KriishAHate/CommonSENSES/README.md

# Urban Sensor Box

Built at the [Environmental Sensing Laboratory](https://envsensorslab.sites.northeastern.edu/) at Northeastern University as part of the [Common Senses Project](https://www.commonsensesproject.org/).

Full build guide: **[https://envsensorslab.github.io/CommonSENSES/](https://envsensorslab.github.io/CommonSENSES/)**

---

## Repository Structure

```
├── assets/        ← engineering drawings, QA cards, code files
├── bom.md         ← bill of materials
├── code/          ← code setup guide
├── deployment/    ← deployment guide
├── electronics/   ← electronics assembly guide
├── mechanical/    ← mechanical assembly guide
└── index.md       ← home page
```
