KriishAHate/CommonSENSES/docs/assets/Deploymentprocedurelist.pdf

Deployment- PROCEDURE LIST

Operator Name: __________________________ Date: _______________

Sensor Box Mounting Tasks

Device Placement

Transport the pre-assembled device to the installation site.

Place the box on its clamp side (the side with the box closing latches).
Caution: Do not place the box on the side with the solar shield to avoid potential damage to external components.

Mounting Procedure

Position the box on the pole at a height of 10 feet to the bottom of the box and ensure that it faces true south (approximately 14 degrees offset from magnetic south at 194 degrees) using the compass.

Secure the box using two hose clamps by passing them through the cross members as shown in the picture:

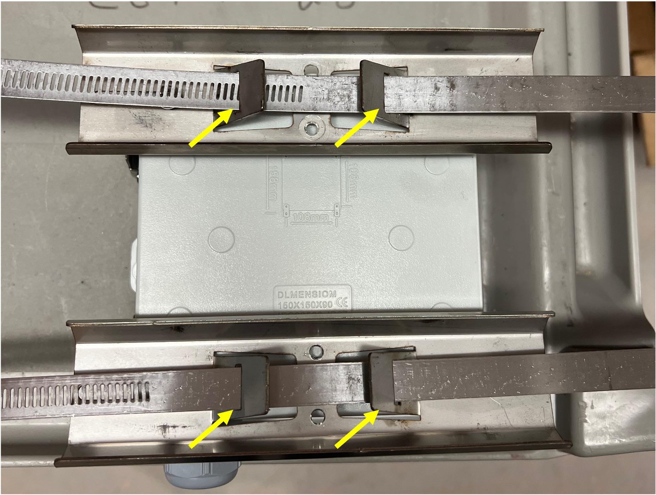
[picture p8: figure]

Lightly tighten the first hose clamp to hold the box in place.

Partially tighten the second clamp so the box is close to secure but can still be rotated to correct southern facing position.

Once both clamps and the solar panel are positioned correctly, fully tighten both to secure the box firmly.

Clip the excess hose clamps using a cutter.

Sensor Box Startup Verification

Power Up

Connect the USB cable to the power bank, use the port as shown in the picture.

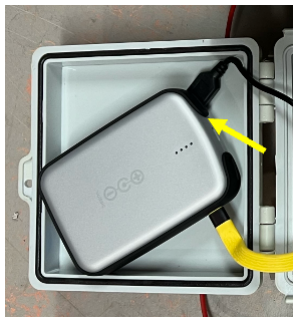
[picture p9: figure]

Press the button on the power bank to verify it has full charge. 4/4 points will light up and the red indicator for the arduino will turn on as shown in the picture.
Note: in some cases due to the winter the points take some time to show up or don't show up at all. In this case proceed with the visual indicator check to confirm that the Arduino is getting power and then look for the sound sensor and LTE module lights.

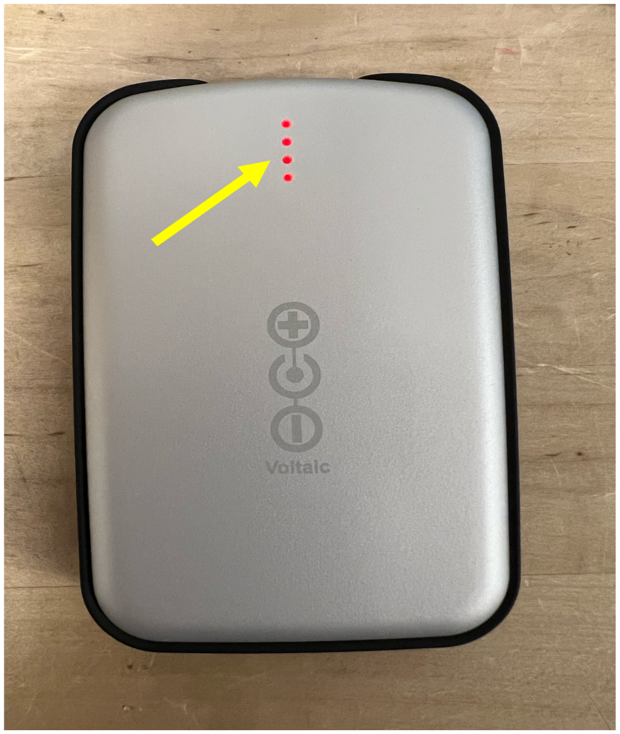
[picture p10: figure]

Visual Indicator Check

- Confirm that all indicator lights are functioning:

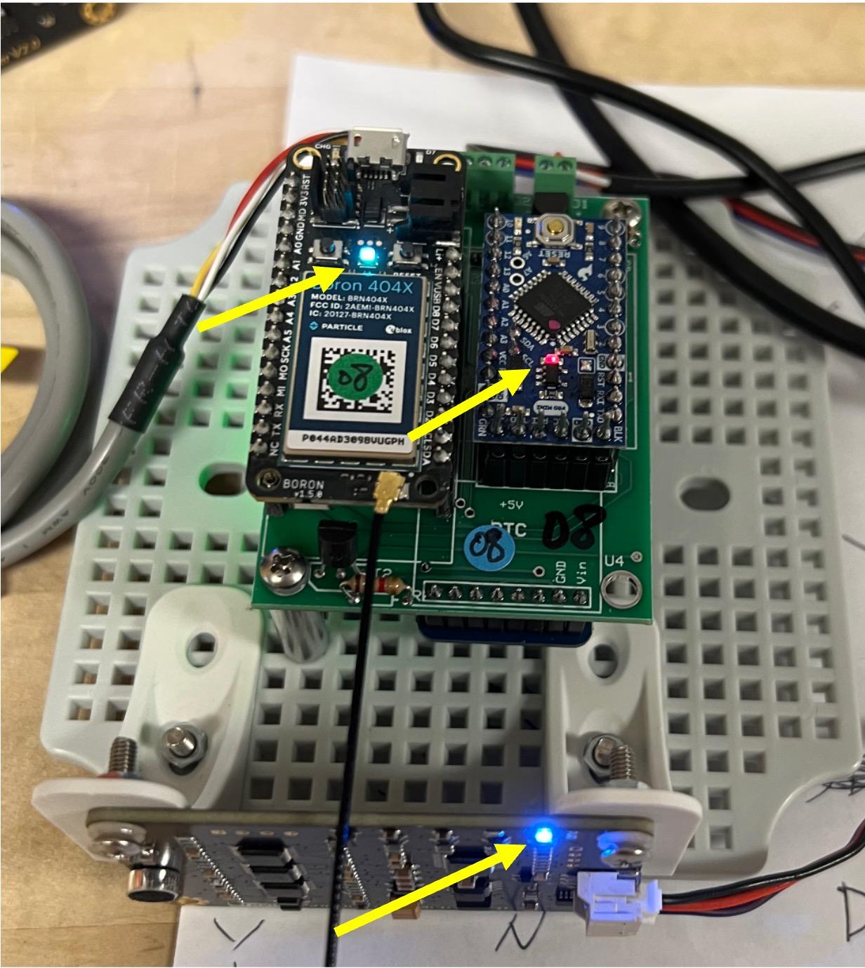
[picture p11: figure]

- Indicator Light Confirmation:

Arduino Green Light: ☐ Yes ☐ No

Sound Sensor Blue Light: ☐ Yes ☐ No

LTE Module Light Blue Light: ☐ Yes ☐ No

Data Upload Confirmation (Particle.io): ☐ Successful ☐ Not Successful (Retrieve box and use the spare boxes that are brought)

Data Transmission Verification

- Log into the particle io website to look for the startup message the module sends when it is powered up to confirm that the cellular module is uploading data. Verify that the Box number matches the Box number in the message as shown by the picture.

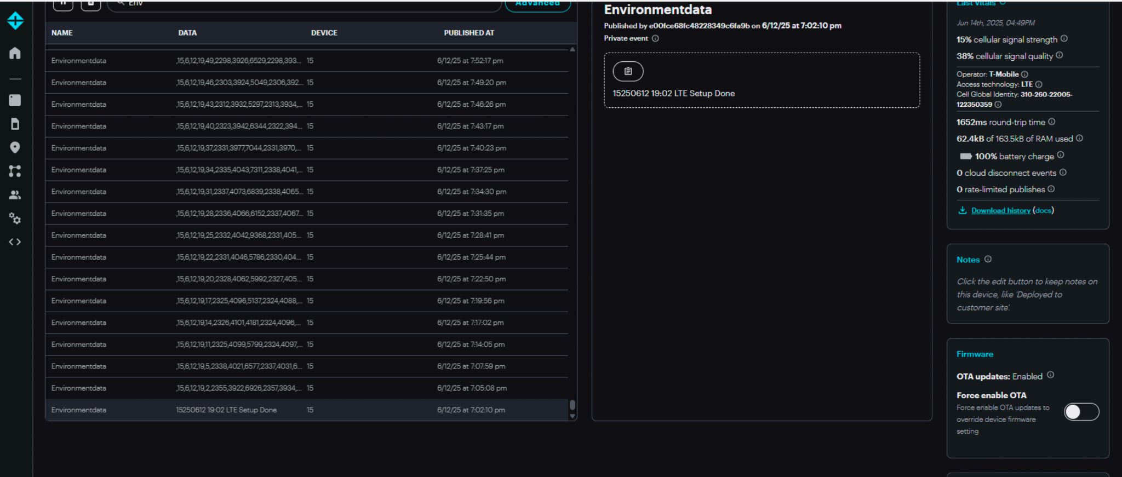
[picture p12: figure]

Box Closing

Check that no electronic wires are caught or pinched before attempting to close the door. Note: Improper closure can seriously affect internal components and cause failures. Close the box door and secure it by threading a zip tie through the hole located on the outer edge of the box as shown in the picture.

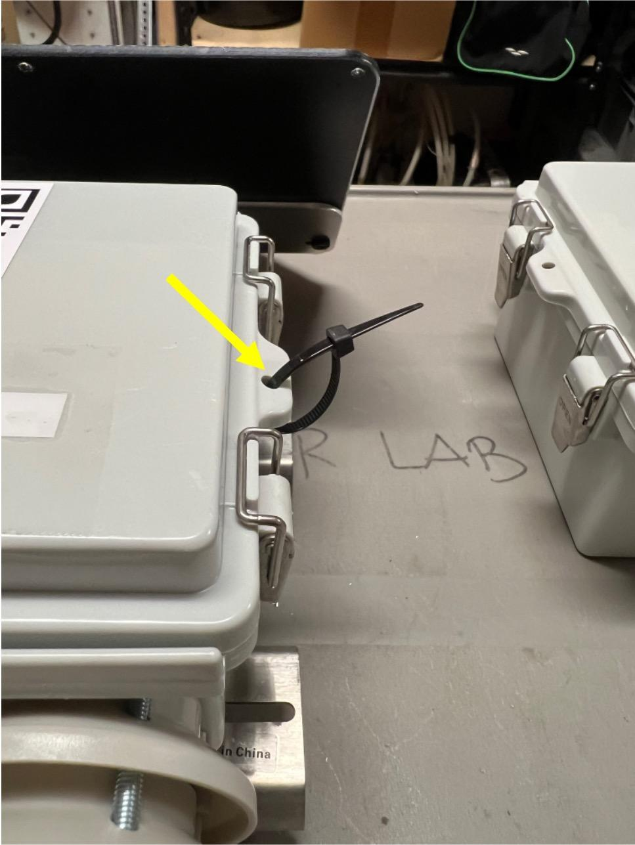
[picture p13: figure]

Important: While closing, ensure the power cable and the yellow solar panel charging cable is not interfering with the box door.

Installation Checklist Recording

- GPS Location: ____________
- Box Number: ____________
- Time of turning on the box after Installation: ________________
- Battery Voltage # of Points: ________________
- Photograph taken☐ Yes ☐ No
