KriishAHate/CommonSENSES/docs/assets/fielddaypackinglist.pdf

Operator Name: ___________ Date: ___________

Essential Tools:

Cordless power drill and extra batteries (charged)

Measuring tape

Socket driver 5/16”

Flathead screwdriver ¼”

Phillips head screwdriver

Precision screwdriver (for small screw terminals)

Large diagonal cutters and large needle nose pliers (for trimming excess hose clamp material)

Utility cutter or small diagonal cutters (for cutting zip ties)

Cart

PPE (Helemts, Reflective Vests)

Work Gloves

Ladder

Installation Components:

Signs (number to be installed) -Qty 8

Mounting hardware for signs (Nuts, Clamps, Wrench, Loctite–In BANDIT BOX)

Hose clamps – 2 per box plus 2 per sign

UV-resistant tape

UV-resistant zip ties (assorted sizes)

Masking tape (to mark 10 ft height)

Deployment Units:

Primary deployment sensor boxes (number to be installed) - Qty 6

Spare/extra deployment boxes – Qty 2

Marking & Orientation and Checklists:

Permanent marker + extra sharpies (Sharpie)

Magnetic compass (for ensuring correct southern orientation of boxes)

Clipboard (Also get binder clips to avoid pages from flying in the field) with 1 set of

packing list and # installation checklists based on number to be installed on the

respective day
