KriishAHate/CommonSENSES/docs/assets/PCBqacard.pdf

PCB Assembly | QA Card

## PCB Assembly QA Card

Inspection Checklist for Soldered PCB

Board Number: | Technician:

Checklist:

□ Solder 2 resistors

Ensure resistors are correctly placed and soldered with clean joints

□ Solder RTC, SD, and ADC female headers

Headers aligned straight and flush with the PCB; no cold joints

□ Solder LTE and Arduino female headers

Verify SDA and SCL header pins are included and correctly oriented

□ Solder 2 MOSFETs

MOSFET orientation must match PCB silkscreen marking

□ Solder 3 screw terminals

Confirm orientation (receiver should face away from the PCB) and that terminals are seated flat on PCB

□ Even solder amount and shape

Concave, shiny finish; no cold joints or solder bridges

□ Visual inspection complete

Check for missing pins, bridges, or cold joints

□ Continuity test passed

Use multimeter to confirm electrical continuity for all signal and power pins

Final Status: □ | Passed | □ | Needs Rework

Date:

Notes:

1
