KriishAHate/CommonSENSES/docs/assets/SDcardqacard.pdf

SD Card Module | QA Card

## SD Card Module QA Card

Individual SD Module Inspection

Board Number: | Technician:

Checklist:

□ Header orientation correct

Placed in correct direction where the SD card is oriented towards the RTC Module. It should sit on the smaller header pins.

□ Soldered SD header securely

Header sits flush; joint fully connects pin and pad

□ Even solder amount and shape

Concave, shiny finish; no cold joints or solder bridges

□ Visual inspection complete

Check for solder bridges or incomplete joints

□ Continuity test passed

Place one multimeter probe on a pin and the other on the adjacent pin to ensure no shorts. Repeat across all pairs of adjacent pins.

Final Status: □ | Passed | □ | Needs Rework

Date:

Notes:

1
