KriishAHate/CommonSENSES/docs/bom.md

# Bill of Materials

Everything you need to build one sensor box. Buy all of these items before you start assembly.

**Estimated total cost per unit: ~$450–$500**

---

## Electronics

| Part | Qty | Cost | Link |
|---|-----|---|---|
| Particle Boron 404X (cellular module) | 1 | $48.95 | [store.particle.io](https://store.particle.io/products/boron-lte-cat-m1-noram-with-ethersim-4th-gen) |
| Arduino Pro Mini 328P (5V) | 1 | $11.95 | [SparkFun](https://www.sparkfun.com/products/11113) |
| AM2315C Temperature + Humidity Sensor | 1 | $26.95 | [Adafruit](https://www.adafruit.com/product/5182) |
| SEN0232 Sound Level Sensor | 1 | $39.50 | [DigiKey](https://www.digikey.com/en/products/detail/dfrobot/SEN0232/8122314) |
| Sound sensor bracket | 30 | $8.79 | [Amazon](https://www.amazon.com/dp/B0CK17CSX7) |
| DS3231 Real-Time Clock | 1 | $17.50 | [Adafruit](https://www.adafruit.com/product/3013) |
| ADS1115 ADC | 1 | $14.95 | [Adafruit](https://www.adafruit.com/product/1085) |
| Adafruit MicroSD Card Breakout Board | 1 | $7.50 | [Adafruit](https://www.adafruit.com/product/254) |
| SD Card | 1 | $8.66 | [Amazon](https://www.amazon.com/dp/B010NE3QHQ) |
| CR1220 Coin Cell Battery (for RTC) | 1 | $0.95 | [Adafruit](https://www.adafruit.com/product/380) |
| Custom PCB | 1 | $13.30 | See repo |
| PCB female headers | 39 | $10.18 | [DigiKey](https://www.digikey.com/en/products/detail/preci-dip/801-87-003-10-001101/3757430) |
| PCB male headers | 39 | $6.91 | [DigiKey](https://www.digikey.com/en/products/detail/harwin-inc/D01-9923246/3918909) |
| TN0702 N-channel MOSFET | 1 | $1.52 | [DigiKey](https://www.digikey.com/en/products/detail/microchip-technology/TN0702N3-G/4902376) |
| 1kΩ Resistor | 1 | $0.10 | [DigiKey](https://www.digikey.com/en/products/detail/stackpole-electronics-inc/CF14JT1K00/1741314) |
| Nylon isolating washer (4-40) | 100 | $5.22 | [McMaster](https://www.mcmaster.com/90295A359) |
| 2-position screw terminal | 1 | $2.75 | [DigiKey](https://www.digikey.com/en/products/detail/pololu-corporation/2491/19200243) |
| 3-position screw terminal | 1 | $2.95 | [DigiKey](https://www.digikey.com/en/products/detail/pololu-corporation/2492/19200270) |
| 4-position screw terminal | 1 | $2.95 | [DigiKey](https://www.digikey.com/en/products/detail/pololu-corporation/2493/19200206) |
| Arduino standoffs | 4 | $2.88 | [DigiKey](https://www.digikey.com/en/products/detail/raf-electronic-hardware/4011-440-AL/9834457) |
| 4-40 screws | 4 | $0.25 | [McMaster](https://www.mcmaster.com/91772A108) |
| M3 screws | 100 | $9.00 | [McMaster](https://www.mcmaster.com/90258A183) |
| M3 nuts | 100 | $3.06 | [McMaster](https://www.mcmaster.com/90591A250) |
| Velcro tape (Scotch RF6731) | 1 | $14.99 | [Amazon](https://www.amazon.com/dp/B07N9JPWJX) |
| USB-A to USB-B cable | 1 | $2.19 | [DigiKey](https://www.digikey.com/en/products/detail/assmann-wsw-components/A-USB20AM-OE-050BE28/10408380) |
| Short USB-C extension cable | 1 | $9.76 | [Amazon](https://www.amazon.com/dp/B0CWGW3LTJ) |

---

## Power System

| Part | Qty | Cost | Link |
|---|-----|---|---|
| Voltaic P105 5W Solar Panel | 1 | $35.00 | [Voltaic](https://voltaicsystems.com/5-watt-panel-etfe) |
| Voltaic 10W Solar Panel | 1 | $65.00 | [Voltaic](https://voltaicsystems.com/10-watt-panel-etfe) |
| Voltaic V50 48Wh Battery | 1 | $65.00 | [Voltaic](https://voltaicsystems.com/v50) |
| USB-C adapter | 1 | $2.25 | [Voltaic](https://voltaicsystems.com/A123) |
| Solar mount (5W panel) | 1 | $9.00 | [Voltaic](https://voltaicsystems.com/BK102) |
| Solar mount (10W panel) | 1 | $19.00 | [Voltaic](https://voltaicsystems.com/BK103) |

---

## Enclosure & Hardware

| Part | Qty | Cost | Link |
|---|-----|---|---|
| IP67 enclosure (TICONN) | 1 | $19.99 | [Amazon](https://www.amazon.com/dp/B0B87VR84G) |
| Aluminum backplate | 1 | $37.11 | [Amazon](https://www.amazon.com/dp/B000H9NA2E) |
| Mounting brackets | 2 | $14.99 | [Amazon](https://www.amazon.com/dp/B0B4DW4HFM) |
| Stainless steel pole clamps | 2 | $9.25 | [Grainger](https://www.grainger.com/product/Surelock-Clamp-304-Stainless-802UR7) |
| Cable gland | 1 | $5.56 | [DigiKey](https://www.digikey.com/en/products/detail/lapp/S1616/11200310) |
| Protective mesh | 6 | $7.74 | [McMaster](https://www.mcmaster.com/9230T51-9230T443/) |
| Spacer | 1 | $0.85 | [McMaster](https://www.mcmaster.com/93657A069) |
| M4 Allen screws | 10 | $5.23 | [McMaster](https://www.mcmaster.com/92855A401) |
| 10-32 screws (5") | 5 | $8.43 | [McMaster](https://www.mcmaster.com/90272A386) |
| Low-profile nuts | 100 | $9.81 | [McMaster](https://www.mcmaster.com/90730A411) |
| Buna-N O-ring (dash 008) | 100 | $2.03 | [McMaster](https://www.mcmaster.com/9452K16) |
| Solar radiation shield (APRS2698) | 1 | $20.00 | [Off Grid Options](https://offgridoptions.com/APRS2698) |

---

!!! tip "Buying in bulk"
    Many of the small hardware items (screws, nuts, washers, O-rings) come in packs of 100. If you're building multiple boxes, the per-unit cost drops significantly.

!!! tip "Solar panel selection"
    The 5W panel is sufficient for deployments in locations with plenty of sunlight. The 10W panel is recommended for locations with limited sun exposure or harsh winters — such as Boston.
