KriishAHate/CommonSENSES/CAD and Schematics/PCB Design /Schematic images/Blue_Hill_Old3.dxf

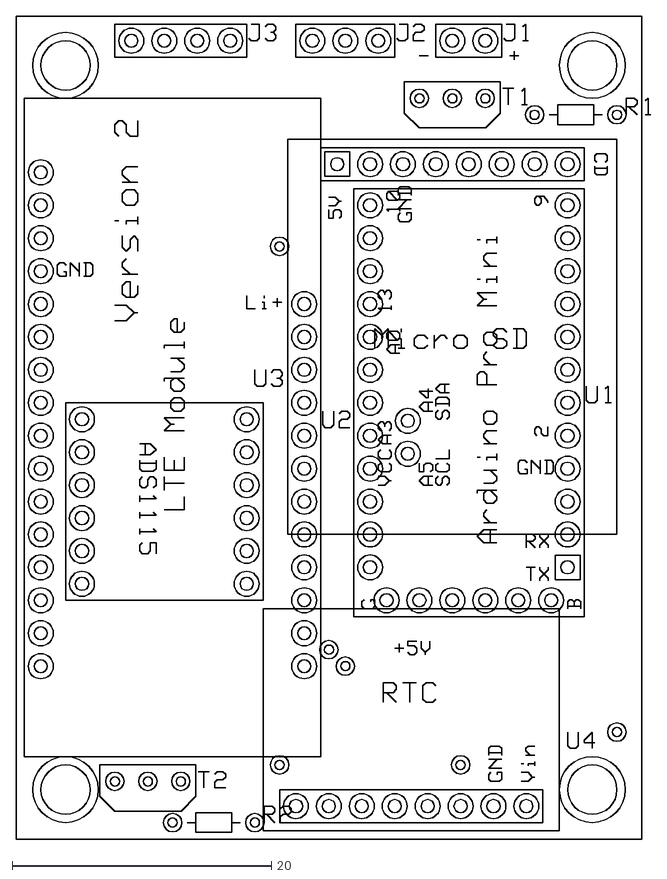
[picture p14: CAD file, 2026-03-15, an earlier design]
CAD and Schematics/PCB Design /Schematic images/Blue_Hill_Old3.dxf
49.0 x 63.5
