KriishAHate/CommonSENSES/docs/assets/BackPlate2.pdf

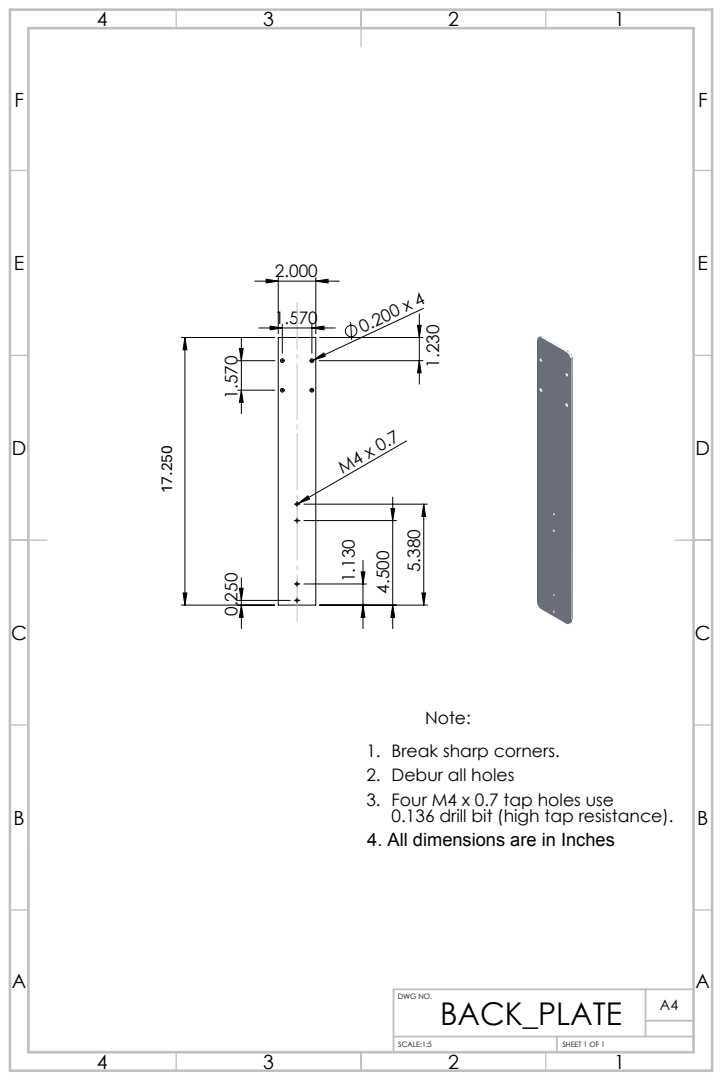
[picture p15: page 1]

Note:
1. Break sharp corners.
Debur all holes
3. Four M4 x 0.7 tap holes use
0.136 drill bit (high tap resistance).
4. All dimensions are in Inches

DWG NO. | A4 BACK_PLATE

SCALE:1:5 | SHEET 1 OF 1
