KriishAHate/CommonSENSES/docs/assets/clampingbracket.pdf

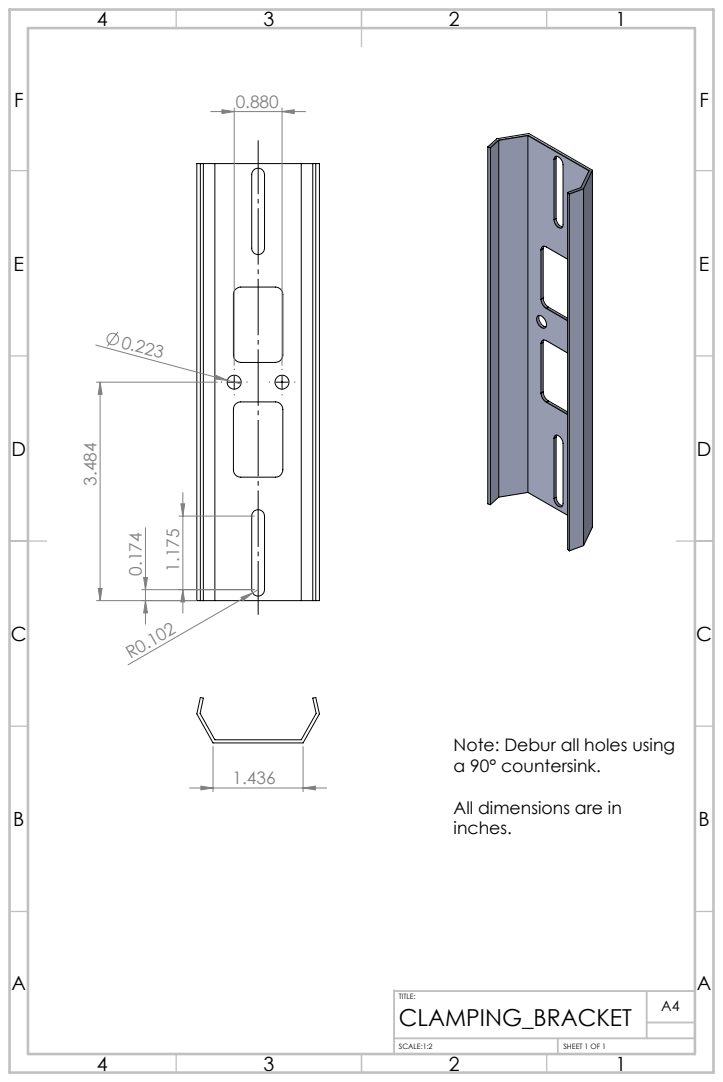
[picture p16: page 1]
SCALE:1:2; SHEET 1 OF 1; A4 CLAMPING_BRACKET

Note: Debur all holes using
a 90° countersink.
All dimensions are in
inches.
