KriishAHate/CommonSENSES/docs/assets/holetemplate.pdf

6

5

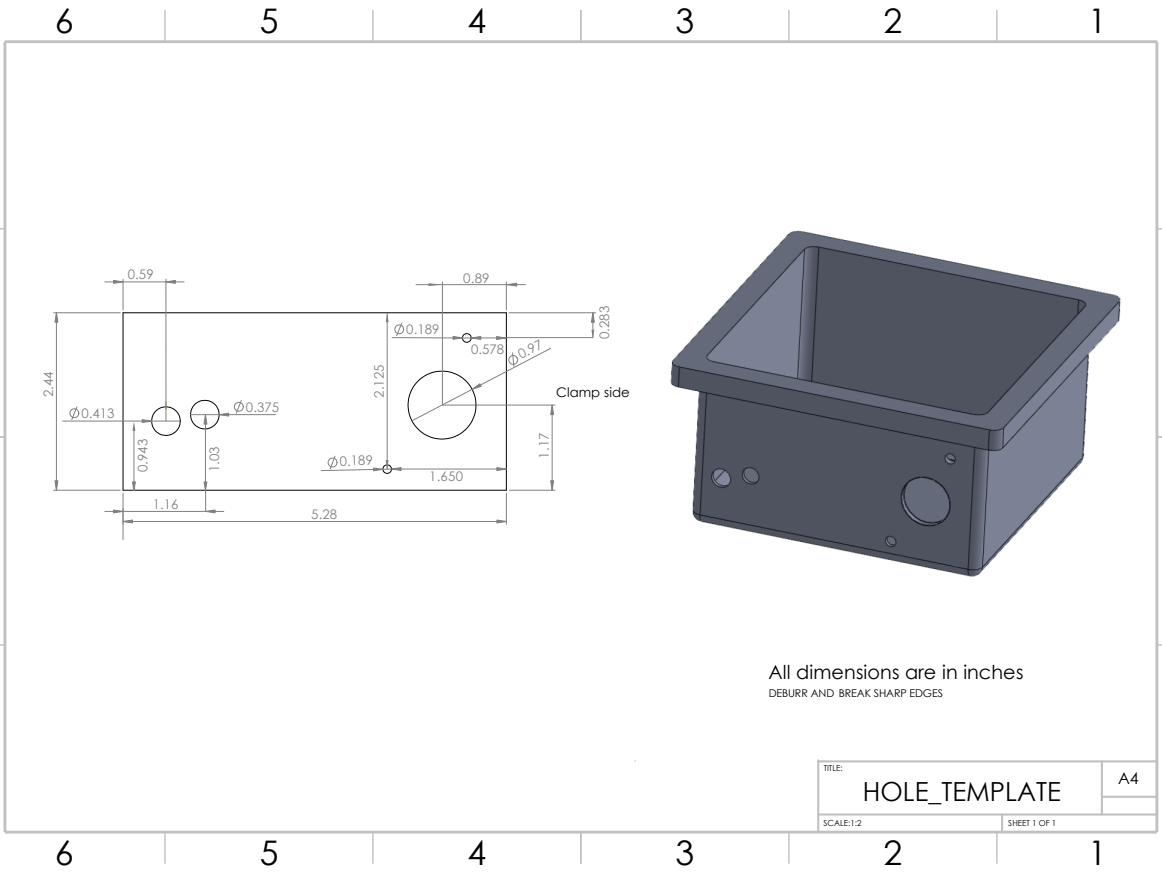
[picture p17: page 1]
Clamp side .4

All dimensions are in inches
DEBURR AND BREAK SHARP EDGES

TITLE: | A4 HOLE_TEMPLATE

SCALE:1:2 | SHEET 1 OF 1
