KriishAHate/CommonSENSES/(list of files, drawings)

Other design files:
CAD and Schematics/PCB Design /Blue_Hill_Old_all/Blue_Hill_Old1.pcb
CAD and Schematics/PCB Design /Blue_Hill_Old_all/Blue_Hill_Old2.pcb
CAD and Schematics/PCB Design /Blue_Hill_Old_all/Blue_Hill_Old3.pcb
