KriishAHate/CommonSENSES/(commit log)

2025-04-30 Uploading all files that I have made so far from the uploaded to the teams folder and sensor data sheets folder
    Also included the sensor data sheets on top of the docs in the uploaded to teams folder
    [20241029_big_hole.csv, 20241029_open.csv, 20241029_small_hole.csv]
2025-04-30 Made changes to the folder organisation
    [20241029_big_hole.csv, 20241029_open.csv, 20241029_small_hole.csv]
2025-05-03 Updated the list that i used for production on 05022025
    Added the production list i used to complete the machining production task. Finishied milling 1 stack of 12 drilling and milling both sides aprt from that 1 hole where I broke the carbide drill. Started the stack of 14 milled 1 side and drilled 4 hoels for 1 side.
2025-05-04 Added RTC QA Card sheets for 05/03/2025
    The RTC QA cards were digitally filled in the lab for all the 30 units for which headers were soldered. I also made a folder for the stainless steel back plate production checklist where I am yet to scan the checklists and upload them as they were filled using hardcopy prints in the machine shop.
2025-05-04 Added the sensor box BOM and the production time estimate
    [Sensor box project bill of materials.xlsx]
2025-05-05 Added first sensor box deployment pictures folder by Dr Mueller
2025-05-07 Made the folder organisation more consistent and added arduino codes currently running on the sensor box.
    I made the file naming conventions more consistent. Added the latest deployed versions of the arduino codes. Renamed the 3 QA cards for the RTC that I did the next day I still need to sign them.
2025-05-07 Added the overall proposed flow of production
    Made this document as I started to produce the boxes and the anticipated flow of production that I came up with as I was on the Job.
2025-05-07 Added all the PCB schematics
    The naming convention needs to be made more intuitive and standardised in the future. Just adding it all on there now.
    [Blue_Hill_Old1.pcb, Blue_Hill_Old1.sch, Blue_Hill_Old2.pcb, Blue_Hill_Old2.sch, Blue_Hill_Old3.pcb, Blue_Hill_Old3.sch]
2025-05-12 Added ADC Header QA Cards
2025-05-13 Uploaded the all 50 QA cards for soldering the Arduino Pro Mini Headers
2025-05-14 Made a folder for keeping track of each sensor box in the field using an inventory folder
    The sensor box component tracker helps in keeping track of each component incase of failure in the field.
    [SensorBox_Component_Tracker.xlsx]
2025-05-14 Arduino male pin 05/06/2025
2025-05-14 Arduino male pin 05/06/2025
    No. 8-50 were finished on 05/06/2025
2025-05-15 ADC male header 05/05/2025
2025-05-16 LTE code version and uploaded date
    [SensorBox_Component_Tracker.xlsx]
2025-05-16 Added the R code file for the 3 sound sensor test
2025-05-16 Renamed the data sheet folder and added the ADC datasheet
    Changed the data sheet folder name to include sensors and individual component data sheets.
2025-05-16 Made a new sensor and component tests folder and filled in QA CARDS for the arduino pro mini 48-50
    [20241029_big_hole.csv, 20241029_open.csv, 20241029_small_hole.csv]
2025-05-16 Added the ino file for the ADC signed it conformation test
2025-05-16 Added the serial monitor screenshot for the ADC signed integer test
2025-05-16 LTE ID and code uploaded date
    LTE 01-55
    [SensorBox_Component_Tracker.xlsx]
2025-05-17 Changed the sensor box inventory folder to a better name
    [SensorBox_Component_Tracker.xlsx]
2025-05-17 Oragnised the 3 sound sensor test sub folders a little better and added the documents for the latest analysis done on 05/16/2025
    Sorted the files used for data analysis of the 3 sound sensor test by data for better organisation and added the additional files that were made on Dr Muellers request like the powerpoint file for easy comparison of graphs and a more intutive analysis in excel.
    [Binning test.xlsx]
2025-05-19 Updated the excel time binning file and explained how I binned the data.
    [Binning test.xlsx]
2025-05-20 Made a folder for solar shield prototyping and added the pictures to a subfolder based on the date I tried the prototype
2025-05-21 Added another folder with todays date in the sound sensor tests folder and added new graphs to the file with more binning intervals up to 800ms
2025-05-21 Added the slides for db plots made for open sensor against small hole from 200ms bins to 100ms
2025-05-21 Added a structured word doc exploring the 3 sound sensor test binning hypothesis and added r code to a separate folder for the graphs generated today
2025-05-22 Filled in the adc QA cards that I soldered 1-25
2025-05-23 Updated the Processed_Sensor_Data excel file to include a percent difference column between sensor 1 and 2
2025-05-25 Updated the sensor box bill of materials file to the latest version on google drive
    Had a few out of date parts that were sent to Dr mueller for replacement orders and some parts that were added during the prototyping process.
    [Sensor box project bill of materials.xlsx]
2025-05-25 Added more schematics to the CAD folder
2025-05-27 Added the 2 sounds sensor test and the 3 sound sensor test code to the sound sensor test experimental plan folder
2025-05-29 Added the % difference graphs and conditional formatting for sensor 1 against 3 and 2 against 3
2025-05-29 Updated the Sound_Sensor_Binning_Analysis doc to include summary results and graphs for open sensor vs big hole and small hole vs big hole
2025-05-29 Added a scipt for binning according to index and did data analysis with progressive binning for small hole vs big hole and open vs big hole
2025-06-02 Arduino LTE module communication test
    Arduino_LTE_Test is the code for Arduino. cs-arduino-lte-test is the code for LTE module.
2025-06-04 Arduino and LTE module communication test code
    Test the communication between Arduino and LTE module.
2025-06-04 Added ADC module
    Added ADC module to convert the analog signal of noise sensor to digital.
2025-06-04 Added Box Number
    Added Box Number to the uploading sample data.
2025-06-05 Changed the T sensor setup time
    Changed the T sensor setup time to 5 seconds
2025-06-05 changed T sensor sampling time
    changed T sensor sampling time to 2 seconds
2025-06-06 Arduino LTE communication test
    Arduino LTE communication test code
2025-06-06 Added the picture which confirms the wiring for my 3 sounds sensor test
2025-06-06 Update SensorBox_Component_Tracker.xlsx added the box numbers
    [SensorBox_Component_Tracker.xlsx]
2025-06-06 Added the sound sensor variability testing data and data analysis
    [2025-04-18 noise sensor validation test.xlsx]
2025-06-09 T&RH sensor test code changes
    Added descriptions to the reading output
2025-06-09 Arduino Deployment Code
2025-06-18 Substituted LTE module 13 with module 5
    Substituted LTE module 13 with module 5, changed the information on the inventory form.
    [SensorBox_Component_Tracker.xlsx]
2025-06-30 Organised the deployment inventory folder and added the deployment checklist
    [SensorBox_Component_Tracker.xlsx]
2025-07-02 Updated the sensor box deployment tracker excel file with more column names
    [SensorBox_Component_Tracker.xlsx]
2025-07-03 Added some more columns to the deployment inventory excel file
    [SensorBox_Component_Tracker.xlsx]
2025-07-03 Updated the sensor box deployment tracker spreadsheet and added the health check spreadsheet
    [SensorBox_Component_Tracker.xlsx]
2025-07-04 Updated the sensor box component tracker file with all components logged in and the box health
    [SensorBox_Component_Tracker.xlsx]
2025-07-08 Updated file names as test deployment pictures and deployment tracker file
    [SensorBox_Component_Tracker.xlsx]
2025-07-16 Updated the deployment track file with box 24s latest deployment
    [SensorBox_Component_Tracker.xlsx]
2025-07-21 RTC battery change
    RTC battery change for Box 14 and 17
    [SensorBox_Component_Tracker.xlsx]
2025-08-01 Update SensorBox_Component_Tracker.xlsx
    Updated the health box health checklist
    [SensorBox_Component_Tracker.xlsx]
2025-08-01 Box testing
    [SensorBox_Component_Tracker.xlsx]
2025-08-01 Updated the sensor box deployment tracker sheet
    [SensorBox_Component_Tracker.xlsx]
2025-08-01 Changed LTE module
    Changed old No.33 LTE with No.54. Renamed No.54 by 33, and removed No.33 LTE module.
    [SensorBox_Component_Tracker.xlsx]
2025-08-01 Updated box 9's temperature sensor change on the deployment tracker file and made sure to specified locations of the stickers in the metadata
    [SensorBox_Component_Tracker.xlsx]
2025-08-01 Swapped LTE34 with 53 and changed battery for RTC37
    [SensorBox_Component_Tracker.xlsx]
2025-08-03 Add Bill of Materials tab with links
2025-08-03 updated bill of materials tab for website
2025-08-03 Update site to add Bill of Materials
2025-08-03 Enable iframe embedding for BOM
2025-08-03 Update BOM page with embedded iframe
2025-08-03 bill of materials modified
2025-08-03 deleted the bill of materials tab from the website
2025-08-03 Removed BOM page and rebuilt site
2025-08-03 Clean deploy without BOM
2025-08-07 Updated sensor deployment tracker sheet as well as the box health sheet
    [SensorBox_Component_Tracker.xlsx]
2025-08-07 Updated box component tracker and updated box deployment pictures
    [SensorBox_Component_Tracker.xlsx]
2025-08-11 Add sensor guide PDF
2025-08-27 Updated the deployment tracker sheet for components 51-55
    [SensorBox_Component_Tracker.xlsx]
2025-08-28 Added the latest sensor box deployment checklists
2025-08-28 Updated the sensor box deployment tracker sheet for the latest deployment of boxes
    [SensorBox_Component_Tracker.xlsx]
2025-08-29 The changes made during the Box test
    Change some batteries for RTC and changed one T sensor
    [SensorBox_Component_Tracker.xlsx]
2025-09-08 Added Cellular Module Serial Number
    [SensorBox_Component_Tracker.xlsx]
2025-09-08 Added Particle module serial number
    [SensorBox_Component_Tracker.xlsx]
2025-09-19 Updated the box deployment tracker sheet
    [SensorBox_Component_Tracker.xlsx]
2025-09-19 added sensor data related and data portal related pdf docs
2025-10-07 Update SensorBox_Component_Tracker.xlsx
    Updated accounts information which Cell modules belong to
    [SensorBox_Component_Tracker.xlsx]
2025-10-08 Register cell module to new account
    Register cell module to new account
    [SensorBox_Component_Tracker.xlsx]
2025-10-09 Register cell modules to new accounts
    [SensorBox_Component_Tracker.xlsx]
2025-10-09 Updated the deployment tracker sheet with dates and log in information
    [SensorBox_Component_Tracker.xlsx]
2025-10-12 Just ran the arduino lte test code which ended up making another folder to run in arduino
2025-10-17 Updated the states of box 37, 42, and 43
    [SensorBox_Component_Tracker.xlsx]
2025-10-17 updated the ID and serial number of cell module 52, 53, 54, and 55
    [SensorBox_Component_Tracker.xlsx]
2025-10-17 Uploaded the deployment Arduino code and cell module code
2025-11-04 Correct the Arduino code version
    [SensorBox_Component_Tracker.xlsx]
2026-03-01 unzipped the deployment arduino code folder
2026-03-02 added backplate and box holes schematic
2026-03-13 Updated the deployment tracker sheet
    [SensorBox_Component_Tracker.xlsx]
2026-03-15 added schematic images in bmp and dxf formats
    [Blue_Hill_Old3.dxf]
2026-03-15 added electrical schematics and machine shop blueprints
2026-03-15 Added datasheets and schematics
2026-03-15 added power consumption test folder and before this more stuff relating to the box
2026-03-22 Updated the particle account passwords on the sensor box component tracker sheet
    [SensorBox_Component_Tracker.xlsx]
2026-03-27 RTC check
    [SensorBox_Component_Tracker.xlsx]
2026-03-27 updated on maintenance of box 08,39,40
    [SensorBox_Component_Tracker.xlsx]
2026-04-27 Removed the sensor box deployment inventory folder
    [SensorBox_Component_Tracker.xlsx]
2026-04-27 Removed the sensor and component tests folder
    [20241029_big_hole.csv, 20241029_open.csv, 20241029_small_hole.csv, 2025-04-18 noise sensor validation test.xlsx, Binning test.xlsx, Processed_Sensor_Data.xlsx]
2026-04-27 Removed all folders and making a public site
    [Blue_Hill_Old1.pcb, Blue_Hill_Old1.sch, Blue_Hill_Old2.pcb, Blue_Hill_Old2.sch, Blue_Hill_Old3.dxf, Blue_Hill_Old3.pcb, Blue_Hill_Old3.sch, Sensor box project bill of materials.xlsx]
2026-05-25 removed an unused wirin.md file
